olegantonov/skywave-sdr/hardware/d1/plots/filter_response.pdf

### VHF

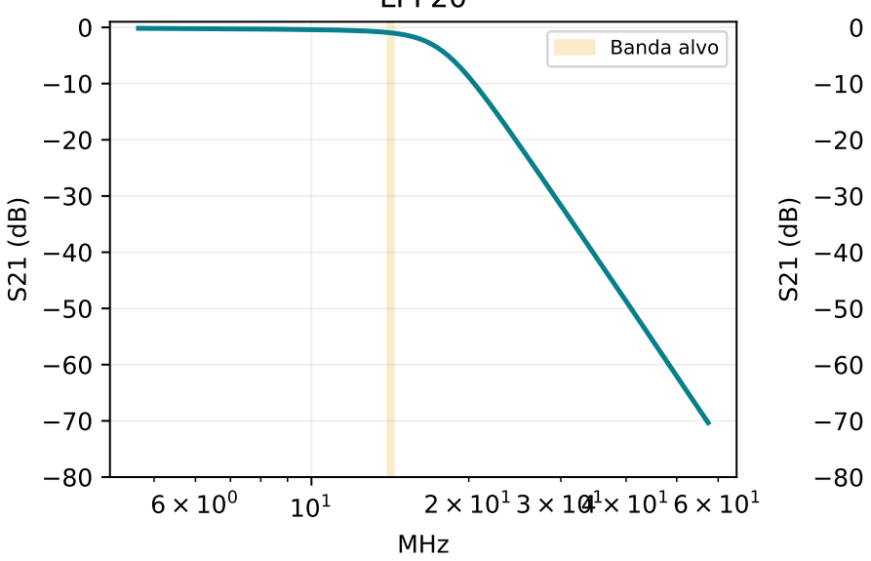
[picture p1: figure]
MHz; Banda alvo
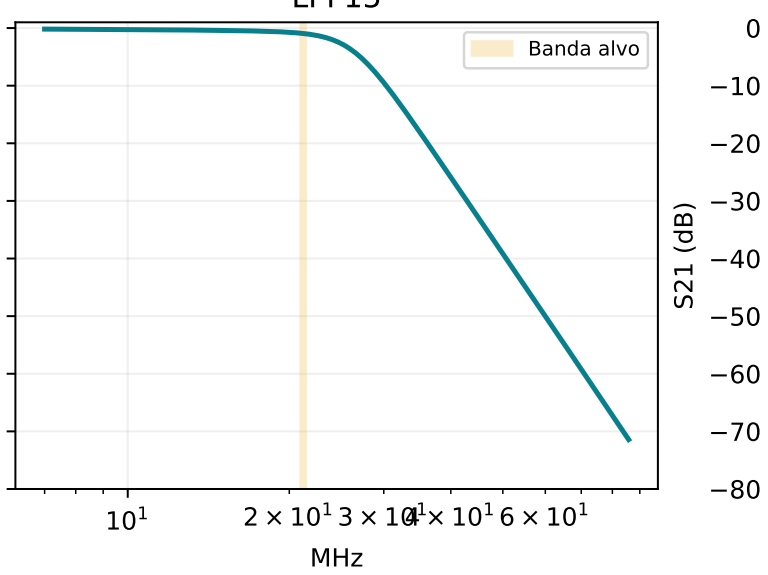
[picture p2: figure]
MHz; Banda alvo

10 2 × 10

2 3 × 104

2× 10

2 6 × 10

2 3
MHz

### UHF

Banda alvo

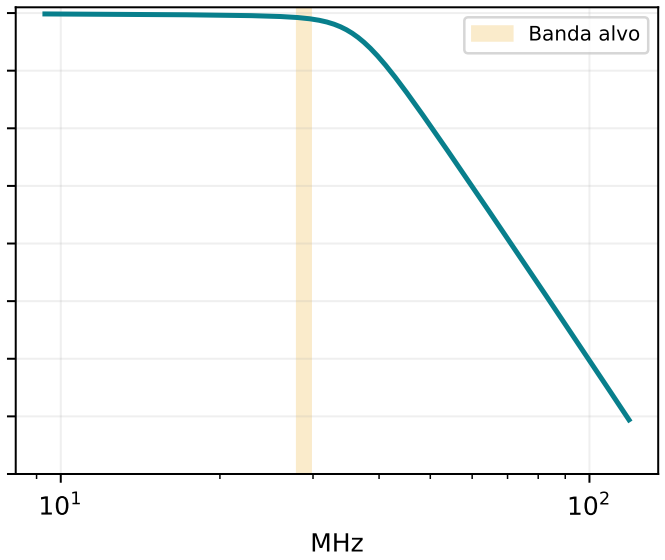
[picture p3: figure]
MHz; Banda alvo

10 3 × 104

0× 10

0 6 × 10

0 | 1 | 2 × 10

1 3 × 10

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
S21 (dB)

### LPF40

Banda alvo

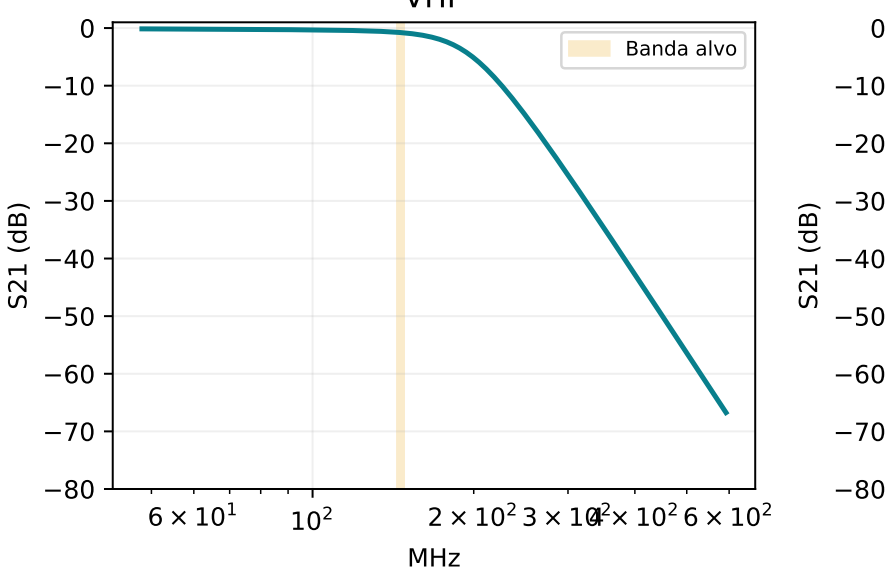
[picture p4: figure]
MHz; Banda alvo

### LPF20

### LPF15

### LPF10

## SkyWave D1 — simulação dos filtros (não é medição)
