olegantonov/skywave-sdr/hardware/d1/plots/filter_response.png

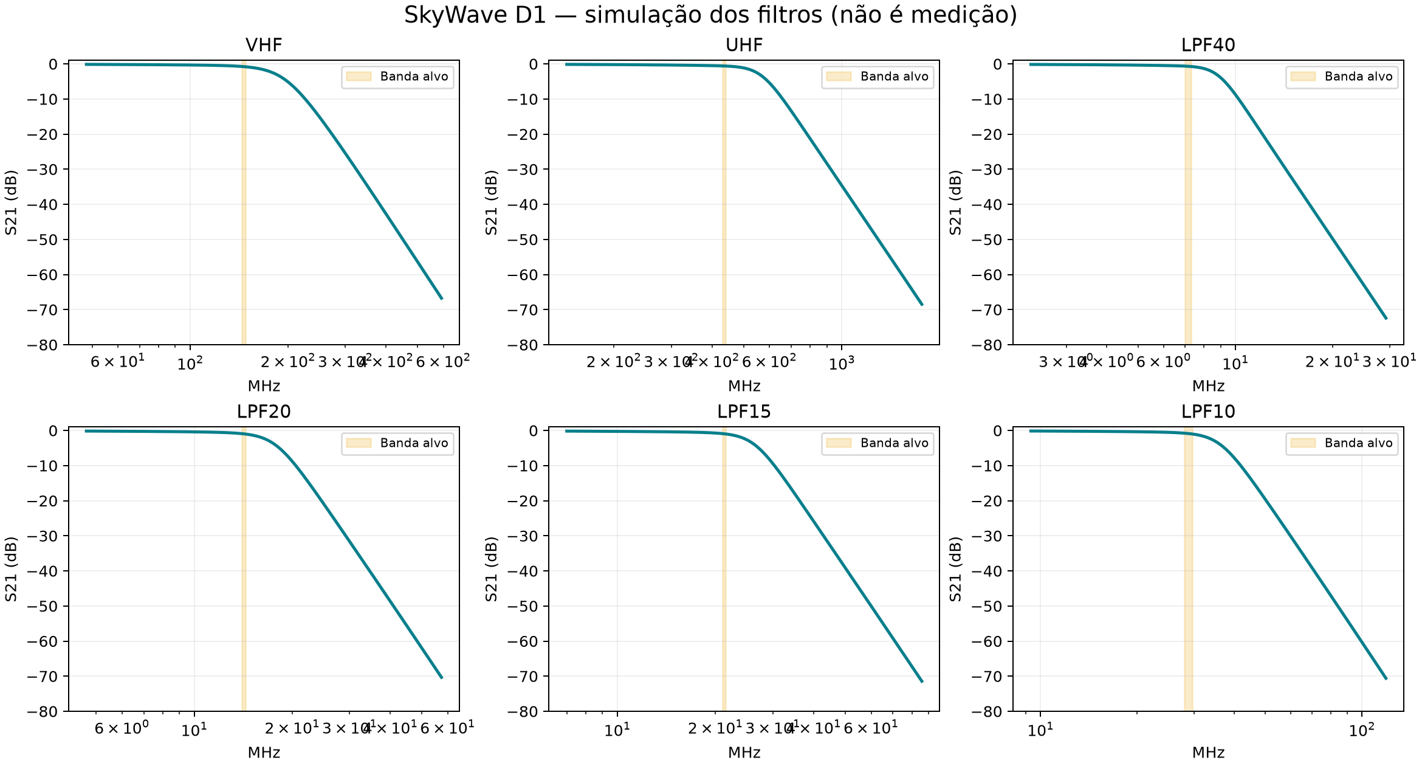
hardware/d1/plots/filter_response.png
