olegantonov/skywave-sdr/hardware/d1/cad/uhf_assembly.step

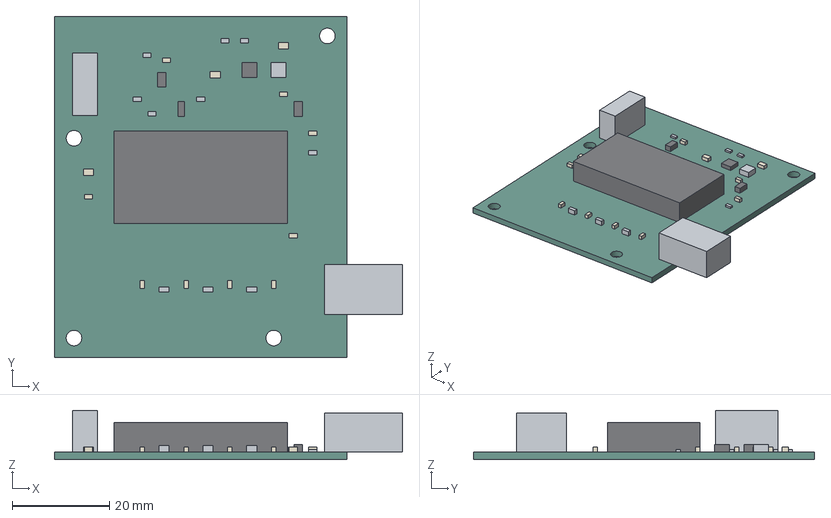
[picture p6: CAD file, 2026-10-12]
hardware/d1/cad/uhf_assembly.step
71.4 x 70.0 x 10.1 mm
laminate
U2
R7
C8
L3
C12
L4
C1
C3
L1
R1
R5
U4
C5
J1
R4
C2
C9
C7
C11
L2
C10
U1
R2
U3
Q1
C6
J2
R6
C4
R3
