olegantonov/skywave-sdr/hardware/d1/cad/lpf10_assembly.step

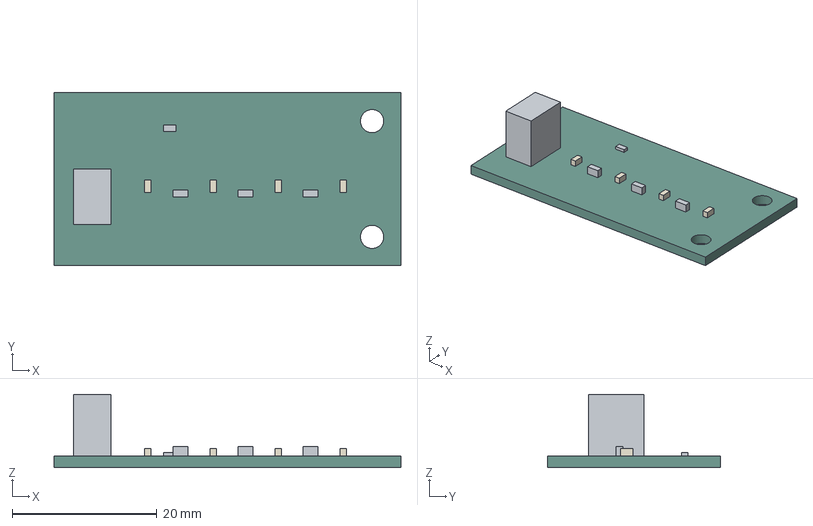
[picture p7: CAD file, 2026-10-12]
hardware/d1/cad/lpf10_assembly.step
48.0 x 24.0 x 10.1 mm
laminate
J1
C1
L1
C2
L2
C3
L3
C4
R1
