olegantonov/skywave-sdr/hardware/d1/cad/control_assembly.step

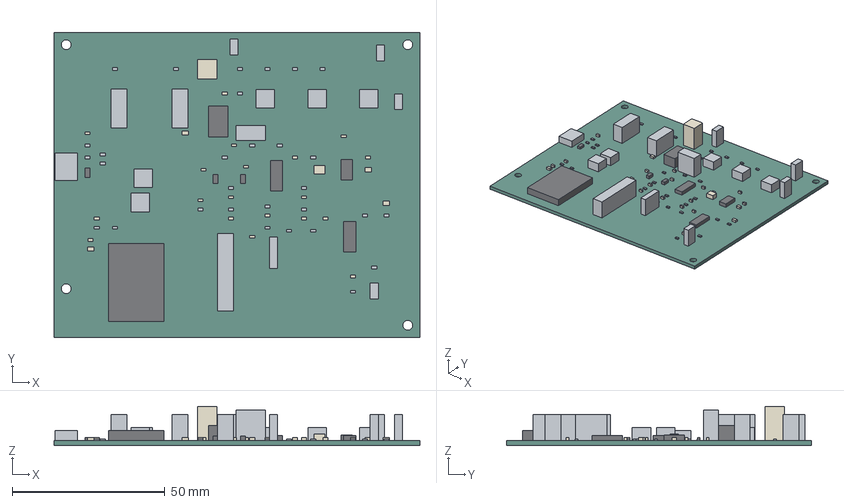
[picture p8: CAD file, 2026-10-12]
hardware/d1/cad/control_assembly.step
120.0 x 100.0 x 12.8 mm
laminate
U1
R1
C1
R2
SW1
SW2
SW3
SW4
SW5
R3
R4
R5
R6
J1
J2
R7
R8
R9
C2
J3
U2
C3
C4
C5
R10
C6
C7
J4
R11
R12
R13
R14
C8
U3
U4
U5
R15
U6
R16
R17
J5
J6
R18
J7
R19
U7
R20
R21
C9
C10
R22
C11
R23
C12
R24
C13
R25
C14
R26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
