olegantonov/skywave-sdr/hardware/d1/cad/control_bare_board.step

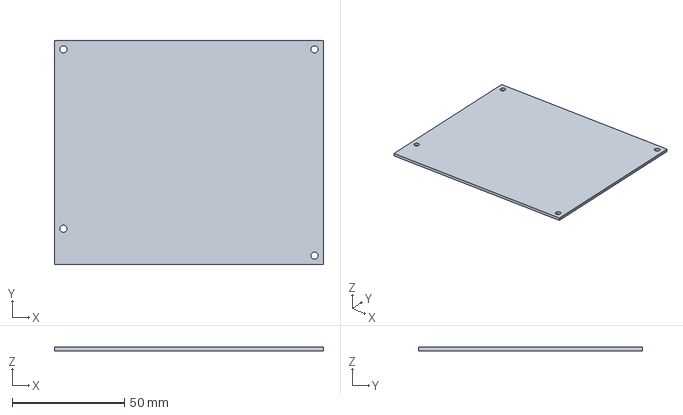
[picture p9: CAD file, 2026-10-12]
hardware/d1/cad/control_bare_board.step
120.0 x 100.0 x 1.60 mm
