olegantonov/skywave-sdr/hardware/d1/cad/button_1.stl

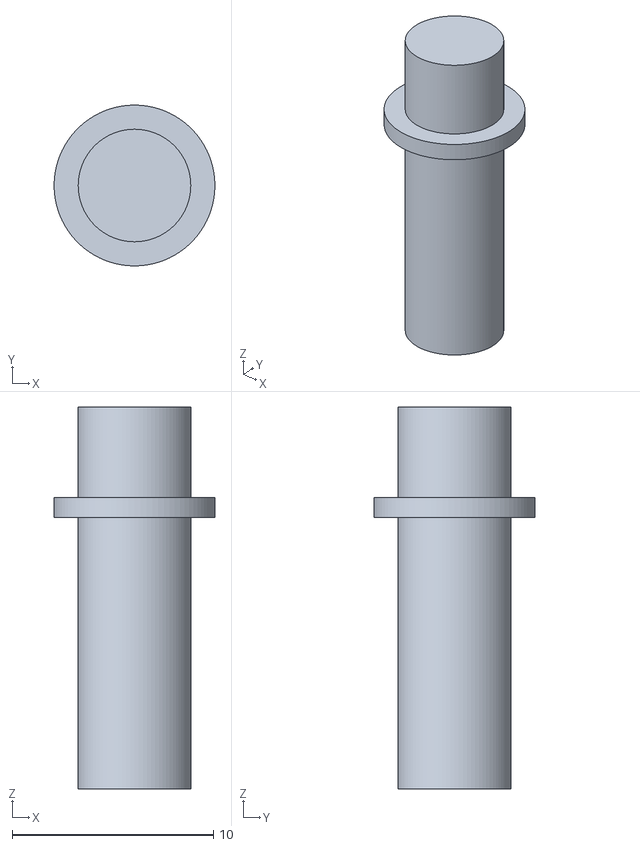
[picture p10: CAD file, 2026-10-12]
hardware/d1/cad/button_1.stl
8.00 x 8.00 x 19.0
