olegantonov/skywave-sdr/hardware/d1/cad/lpf40_bare_board.step

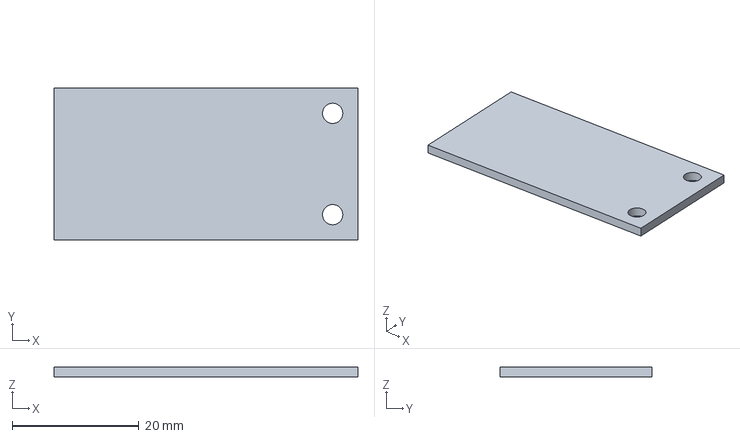
[picture p11: CAD file, 2026-10-12]
hardware/d1/cad/lpf40_bare_board.step
48.0 x 24.0 x 1.60 mm
