olegantonov/skywave-sdr/hardware/d1/cad/enclosure_lid.stl

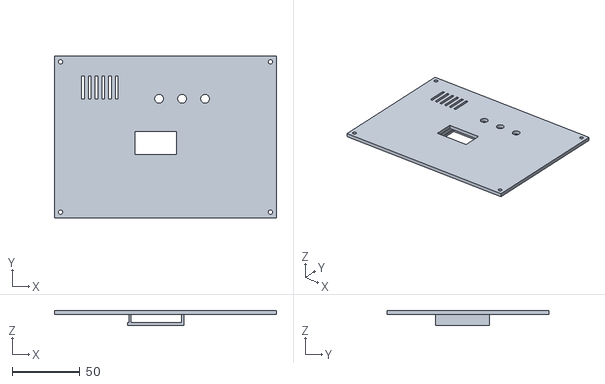
[picture p12: CAD file, 2026-10-12]
hardware/d1/cad/enclosure_lid.stl
164.0 x 120.0 x 11.0
