olegantonov/skywave-sdr/hardware/d1/cad/enclosure_base.step

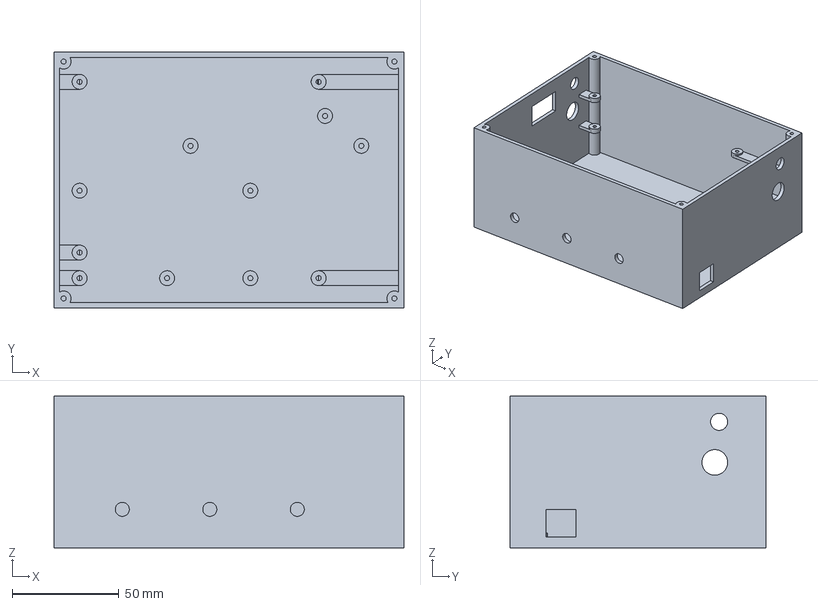
[picture p13: CAD file, 2026-10-12]
hardware/d1/cad/enclosure_base.step
164.0 x 120.0 x 71.0 mm
