olegantonov/skywave-sdr/(list of files, cad)

Other CAD files:
hardware/d1/cad/vhf_assembly.step
hardware/d1/cad/lpf15_assembly.step
hardware/d1/cad/lpf40_assembly.step
hardware/d1/cad/lpf20_assembly.step
hardware/d1/cad/lpf20_bare_board.step
hardware/d1/cad/control_bare_board.stl
hardware/d1/cad/lpf40_bare_board.stl
