olegantonov/skywave-sdr/hardware/d1/plots/control_schematic.pdf

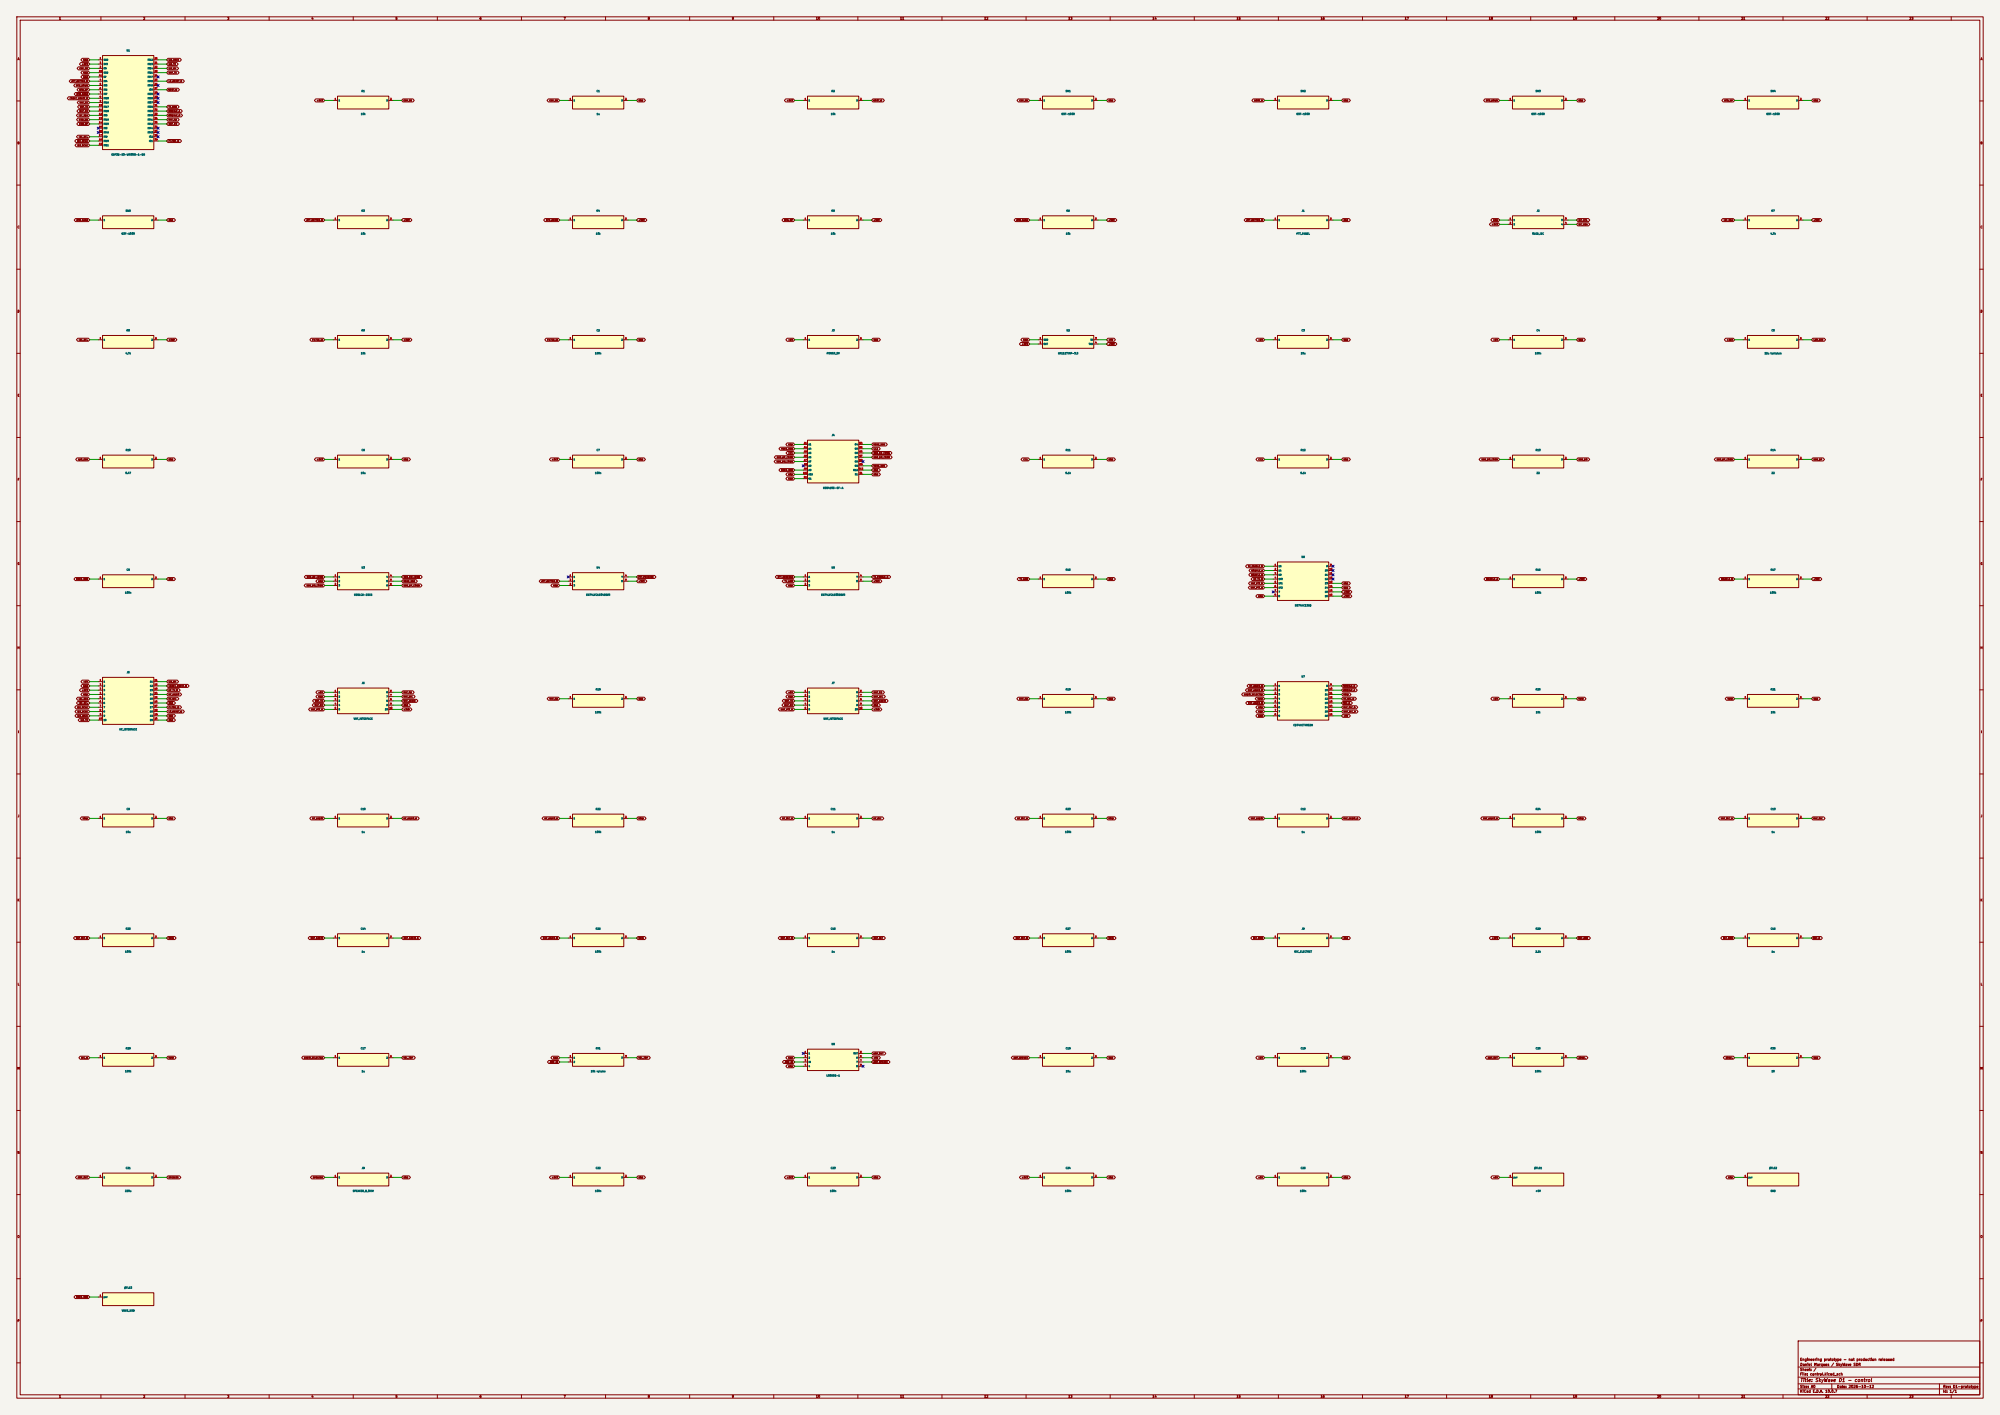
[picture p14: page 1]

Engineering prototype - not production released
Daniel Marques / SkyWave SDR
Sheet: /
File: control.kicad_sch
Title: SkyWave D1 - control

Size: A0 | Rev: D1-prototype
KiCad E.D.A. 10.0.7 | Id: 1/1
