olegantonov/skywave-sdr/hardware/d1/plots/lpf10_schematic.pdf

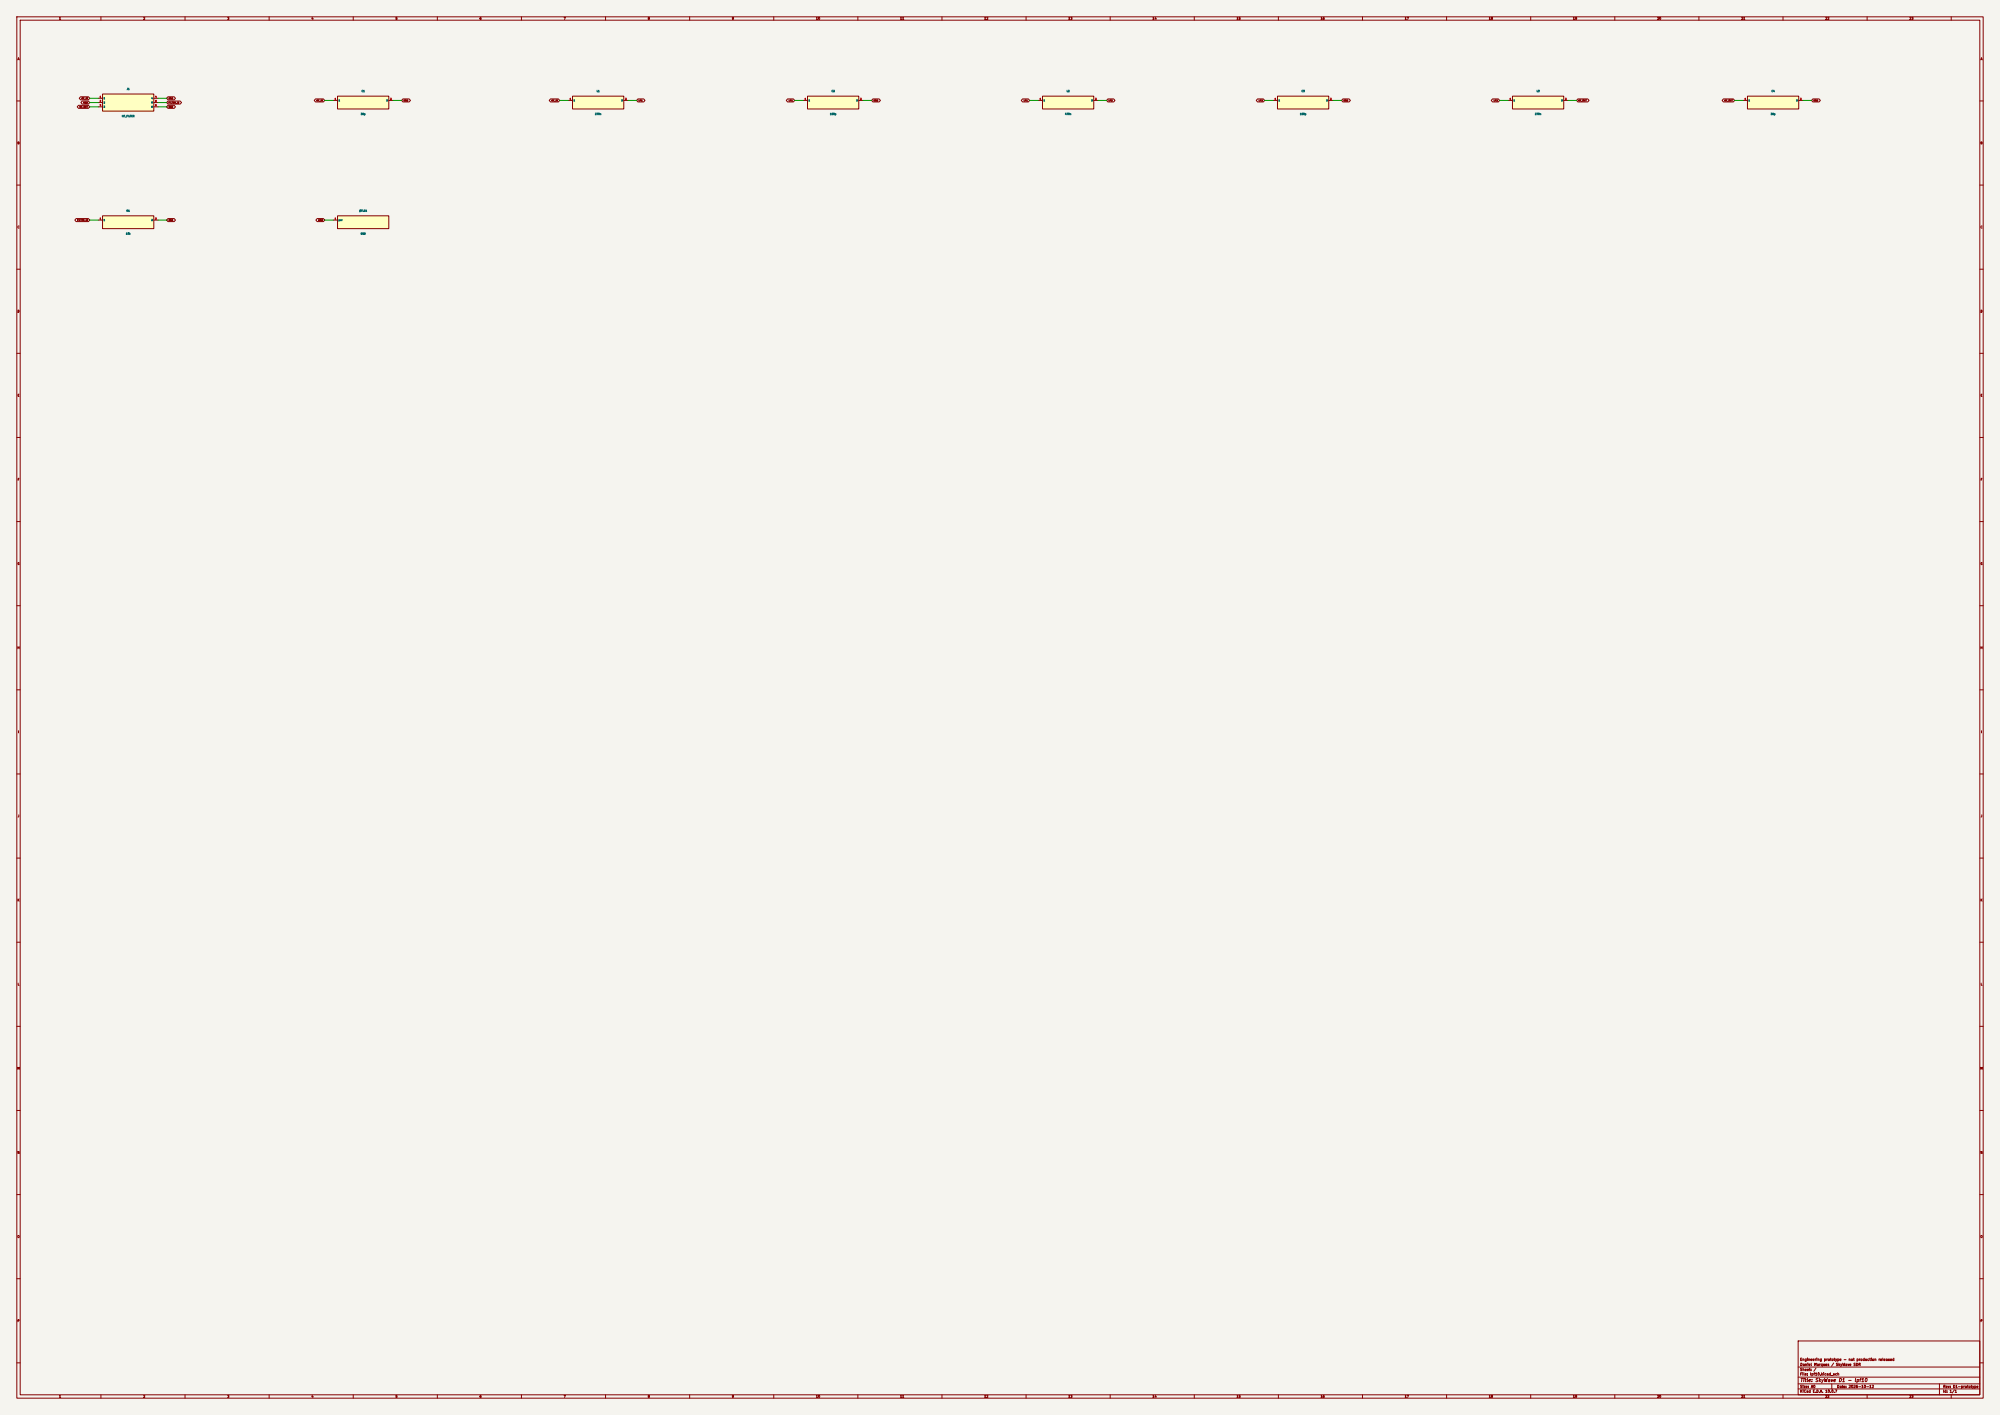
[picture p15: page 1]

Engineering prototype - not production released
Daniel Marques / SkyWave SDR
Sheet: /
File: lpf10.kicad_sch
Title: SkyWave D1 - lpf10

Size: A0 | Rev: D1-prototype
KiCad E.D.A. 10.0.7 | Id: 1/1
