olegantonov/skywave-sdr/hardware/d1/plots/lpf15_schematic.pdf

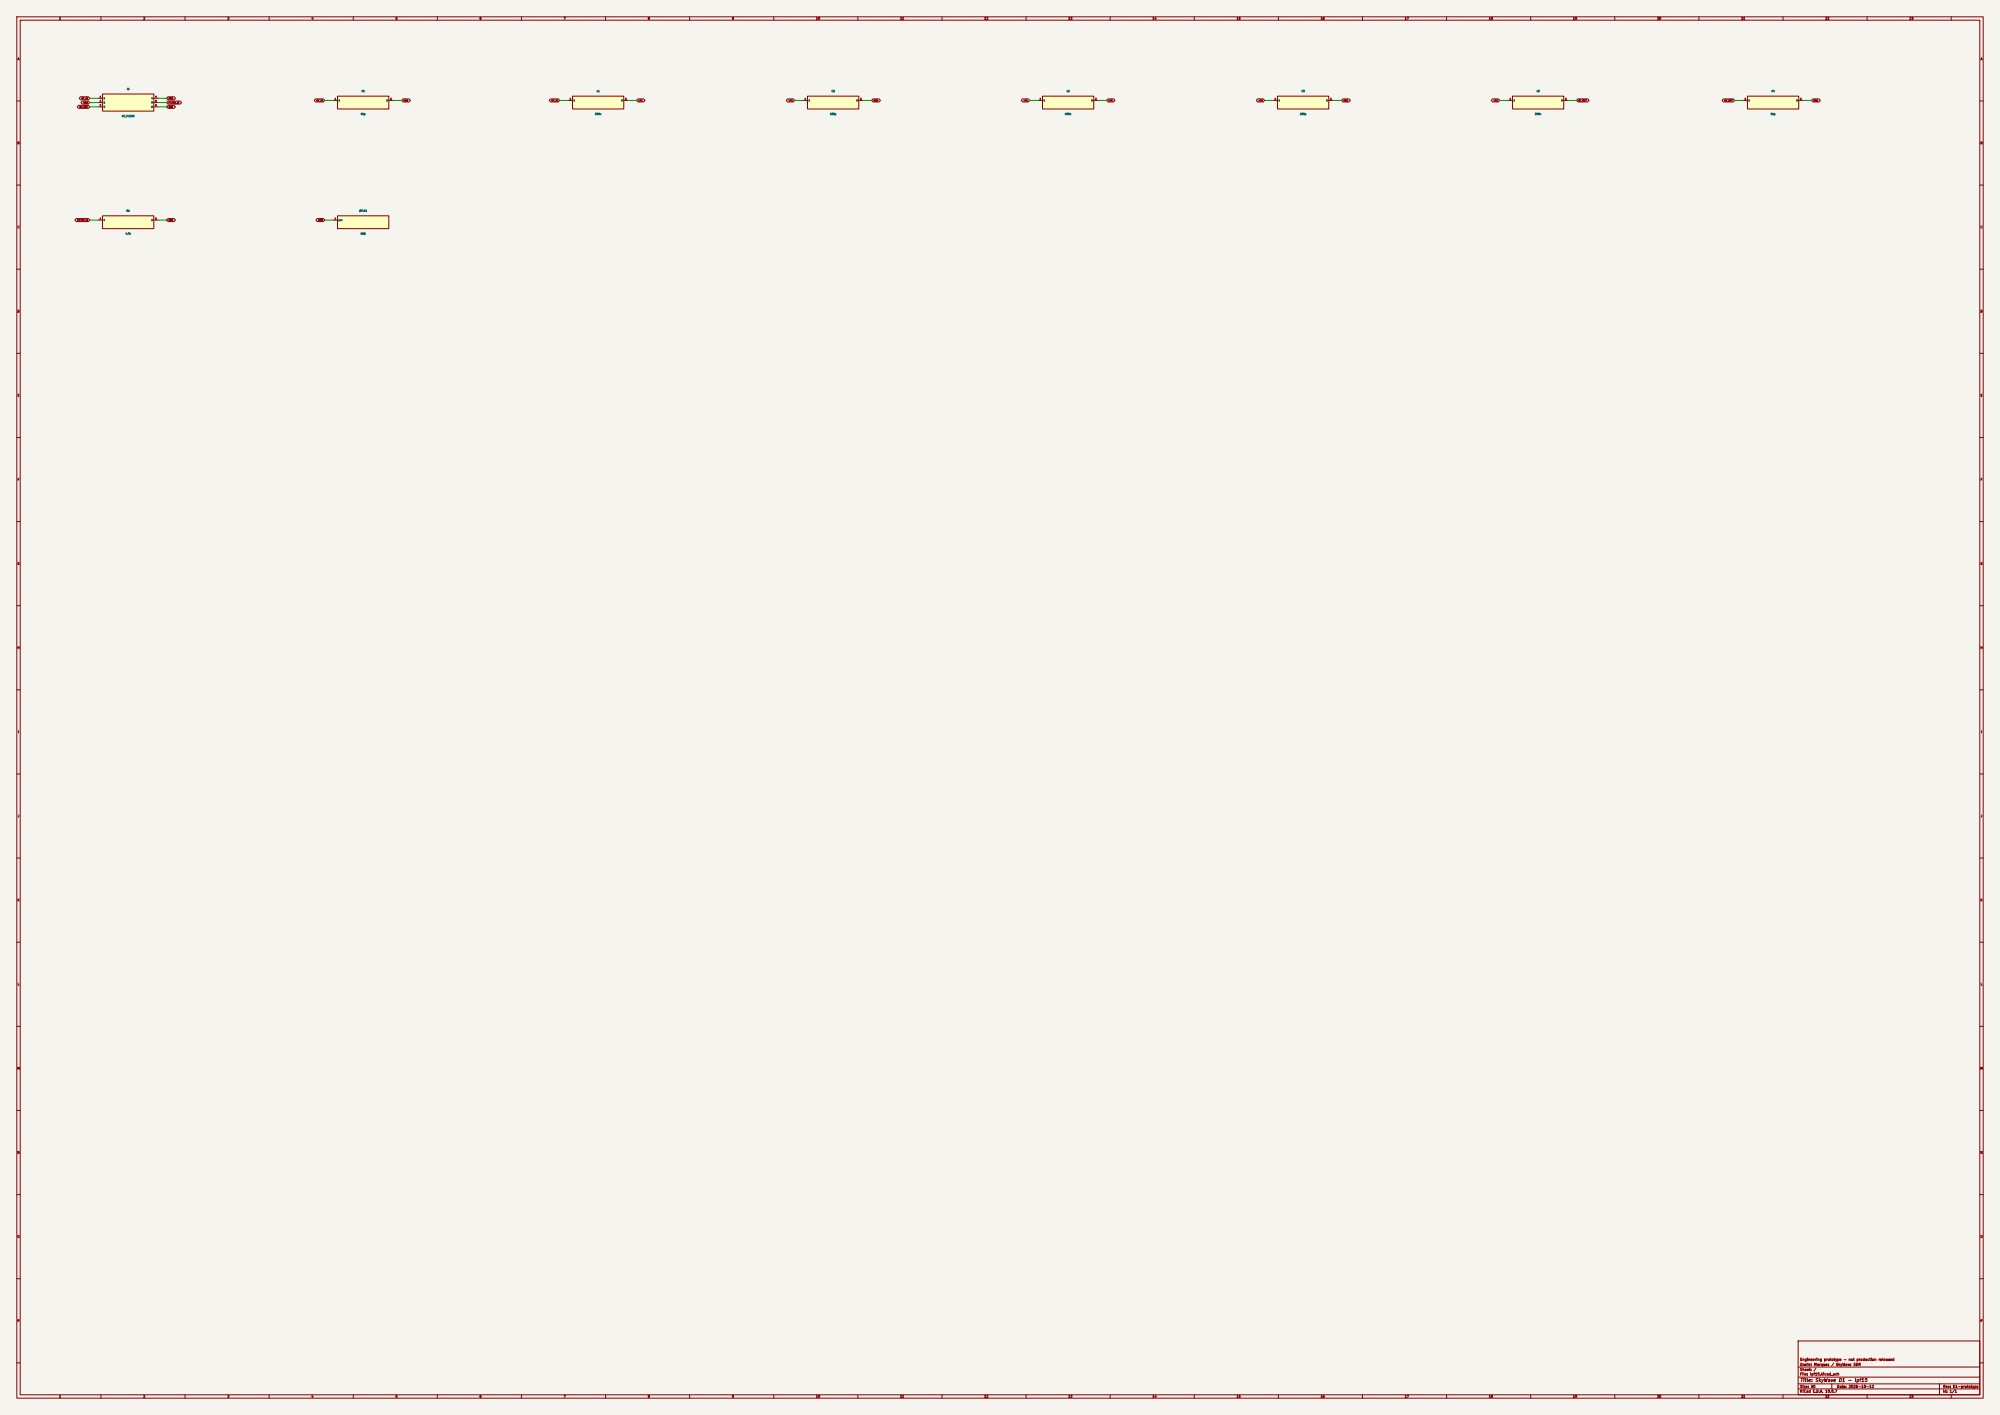
[picture p16: page 1]

Engineering prototype - not production released
Daniel Marques / SkyWave SDR
Sheet: /
File: lpf15.kicad_sch
Title: SkyWave D1 - lpf15

Size: A0 | Rev: D1-prototype
KiCad E.D.A. 10.0.7 | Id: 1/1
