olegantonov/skywave-sdr/hardware/d1/simulation/uhf.cir

SkyWave uhf nominal LPF; ideal LC, 50 ohm terminations
V1 source 0 AC 1
RS source n0 50
RL n3 0 50
C1 n0 0 2.4p
L1 n0 n1 18n
C2 n1 0 10p
L2 n1 n2 27n
C3 n2 0 10p
L3 n2 n3 18n
C4 n3 0 2.4p
.control
set wr_singlescale
set wr_vecnames
ac dec 150 143333333.33333334 1760000000.0
let s21_db = db(v(n3)*2)
wrdata uhf.dat s21_db
quit
.endc
.end
