olegantonov/skywave-sdr/(list of files, drawings)

Other design files:
hardware/d1/ecad/lpf15.dsn
hardware/d1/ecad/lpf40.dsn
hardware/d1/ecad/uhf.dsn
