olegantonov/skywave-sdr/hardware/d1/ecad/hf.kicad_pcb

## KiCad design hardware/d1/ecad/hf.kicad_pcb (2026-10-12)

Schematic: hf.kicad_sch, SkyWave D1 - hf

Parts:
C1, C2, C8, C9, C16, C20, C22, C25: 1u; Capacitor_SMD_C_0603_1608Metric; MPN KEMET 0603 X7R 25V; 1u; 5% RF/10% decou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
C3, C4, C5, C6, C10, C11, C21, C28, C29, C30, C35, C36: 100n; Capacitor_SMD_C_0603_1608Metric; MPN KEMET 0603 X7R 25V; 100n; 5% RF/10% dec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
C7, C12, C37, C38: 10u; Capacitor_SMD_C_0805_2012Metric; MPN KEMET 0805 X7R 25V; 10u; 5% RF/10% deco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
C13, C14, C17, C18: 100p; Capacitor_SMD_C_0603_1608Metric; MPN KEMET 0603 C0G 25V; 100p; 5% RF/10% dec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
C15, C19, C23, C24, C26, C27, C31, C32, C33, C34: 10n; Capacitor_SMD_C_0603_1608Metric; MPN KEMET 0603 C0G 25V; 10n; 5% RF/10% deco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
D1: 1N4148W; Diode_SMD_D_SOD-123; MPN 1N4148W
J1: CONTROL_INTERFACE; Connector_PinHeader_2.54mm_PinHeader_2x10_P2.54mm_Vertical; MPN Samtec TSW-010-07-D-S
J2: FILTER_CARTRIDGE; Connector_PinHeader_2.54mm_PinHeader_2x03_P2.54mm_Vertical; MPN Samtec TSW-003-07-D-S
J3: SMA 132289; Connector_Coaxial_SMA_Amphenol_132289_EdgeMount; MPN Amphenol 132289
K1: G6K-2F-Y-DC5; Relay_SMD_Relay_DPDT_Omron_G6K-2F-Y; MPN G6K-2F-Y-DC5
Q1: 2N7002; Package_TO_SOT_SMD_SOT-23; MPN 2N7002
R1, R3, R4, R5, R6, R7, R9, R12, R14, R18, R19, R23, R24: 10k; Resistor_SMD_R_0603_1608Metric; MPN CRCW0603 series; value=10k; 1%
R2: 33; Resistor_SMD_R_0603_1608Metric; MPN CRCW0603 series; value=33; 1%
R8, R10, R13, R15, R17, R22, R29: 100k; Resistor_SMD_R_0603_1608Metric; MPN CRCW0603 series; value=100k; 1%
R11, R16: 1k; Resistor_SMD_R_0603_1608Metric; MPN CRCW0603 series; value=1k; 1%
R20, R21, R25, R26: 100; Resistor_SMD_R_0603_1608Metric; MPN CRCW0603 series; value=100; 1%
R27, R28: 49.9; Resistor_SMD_R_0603_1608Metric; MPN CRCW0603 series; value=49.9; 1%
U1: TLV75518PDBVR; Package_TO_SOT_SMD_SOT-23-5; MPN TLV75518PDBVR
U2: TLV320AIC3204IRHBR; Package_DFN_QFN_Texas_RHB0032E_VQFN-32-1EP_5x5mm_P0.5mm_EP3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; MPN TLV320AIC3204IRHBR
U3: SI5351A-B-GT; Package_SO_MSOP-10_3x3mm_P0.5mm; MPN SI5351A-B-GT
U4: 74LVC74APW; Package_SO_TSSOP-14_4.4x5mm_P0.65mm; MPN 74LVC74APW
U5: SN74LVC1G04DBVR; Package_TO_SOT_SMD_SOT-23-5; MPN SN74LVC1G04DBVR
U6, U7: TLV9064IDR; Package_SO_SOIC-14_3.9x8.7mm_P1.27mm; MPN TLV9064IDR
U8, U9: SN74CBT3253DR; Package_SO_SOIC-16_3.9x9.9mm_P1.27mm; MPN SN74CBT3253DR
Y1: 25MHz 10pF; Crystal_Crystal_SMD_3225-4Pin_3.2x2.5mm; MPN Abracon ABM8-25.000MHZ-10-1-U-T

Connections:
+1V8: C2.1, C4.1, C5.1, U1.5 (OUT), U2.24 (AVDD), U2.29 (DVDD)
+3V3: C1.1, C3.1, C6.1, C10.1, C11.1, C38.1, J1.3, R4.2, U1.1, U1.3, U2.6 (IOVDD), U2.26 (LDOIN), U3.1, U3.7, U4.4, U4.10, U4.14, U5.5
+5V: C21.1, C28.1, C29.1, C30.1, C37.1, D1.1, J1.1, K1.1, R5.1, U6.4, U7.4, U8.16, U9.16
ADC_I: C16.2, U2.13 (IN1L)
ADC_Q: C20.2, U2.14 (IN1R)
ANT_HF: J2.3, J3.1
AUDIO_RAW: C8.1, U2.25 (HPL)
CODEC_REF: C7.1, U2.18 (REF)
CODEC_RESET_N: J1.12, R1.1, U2.31 (RESET)
COIL_LOW: D1.2, K1.8, Q1.3
DAC_I: C22.1, U2.22 (LOL)
DAC_Q: C25.1, U2.23 (LOR)
DET_IN: C34.1, R9.1, U8.3, U8.13
DET_IP: C31.1, R7.1, U8.6, U8.10
DET_QN: C33.1, R14.1, U8.4, U8.12
DET_QP: C32.1, R12.1, U8.5, U8.11
FILTER_ID: J1.17, J2.5
GND: C1.2, C2.2, C3.2, C4.2, C5.2, C6.2, C7.2, C10.2, C11.2, C12.2, C15.2, C19.2, C21.2, C28.2, C29.2, C30.2, C37.2, C38.2, J1.2, J1.4, J1.16, J1.19, J1.20, J2.2, J2.4, J2.6, J3.2, Q1.2, R1.2, R3.2, R6.2, R29.2, U1.2, U2.7 (IOVSS), U2.8 (MFP3), U2.12 (SPI_SEL), U2.17 (AVSS), U2.28 (DVSS), U2.30 (LDO_SEL), U2.33 (EP), U3.8, U4.7, U5.3, U6.11, U7.11, U8.8, U9.8, Y1.2, Y1.4
HF_AUDIO: C8.2, J1.14
HF_MIC: C9.1, J1.15
HF_TX: Q1.1, R29.1, U5.4 (Y), U8.1, U8.15
HF_TX_N: J1.13, R4.1, U5.2, U9.1, U9.15
I2C_SCL: J1.6, U2.9 (SCL), U3.4 (SCL)
I2C_SDA: J1.5, U2.10 (SDA), U3.5 (SDA)
I2S_BCLK: J1.8, U2.2 (BCLK)
I2S_LRCK: J1.9, U2.3 (WCLK)
I2S_MCLK: J1.7, U2.1 (MCLK)
I2S_RX: J1.11, U2.5 (DOUT)
I2S_TX: J1.10, U2.4 (DIN)
LO4: R2.2, U4.3, U4.11
LO4_RAW: R2.1, U3.10 (CLK0)
LO_I: U4.5 (1Q), U4.12, U8.14, U9.14
LO_Q: U4.9 (2Q), U8.2, U9.2
LO_Q_N: U4.2, U4.8 (2Q_N)
LO_RESET_N: J1.18, R3.1, U4.1, U4.13
LP_I: C15.1, C16.1, R11.2
LP_Q: C19.1, C20.1, R16.2
MIC_IN: C9.2, U2.15 (IN2L)
MIX_RX: C35.2, R27.1, U8.7, U8.9
MIX_TX: C36.1, U9.7, U9.9
RF_COMMON: J2.1, K1.3
RF_RX: C35.1, K1.2
RF_TX: K1.4, R28.2
RX_I: C14.2, R10.2, R11.1, U6.1 (OUT1)
RX_I_NEG: C14.1, R9.2, R10.1, U6.2
RX_I_POS: C13.1, R7.2, R8.1, U6.3
RX_Q: C18.2, R15.2, R16.1, U6.7 (OUT2)
RX_Q_NEG: C18.1, R14.2, R15.1, U6.6
RX_Q_POS: C17.1, R12.2, R13.1, U6.5
SPARE_OUT: U6.13, U6.14 (OUT4)
TX_AC: C36.2, R28.1
TX_IN: R19.2, R21.1, U7.7 (OUT2)
TX_IN_F: C24.1, R21.2, U9.3, U9.13
TX_IP: R18.1, R20.1, U7.1 (OUT1), U7.2
TX_IP_F: C23.1, R20.2, U9.6, U9.10
TX_I_BIAS: C22.2, R17.1, U7.3
TX_I_INV: R18.2, R19.1, U7.6
TX_QN: R24.2, R26.1, U7.14 (OUT4)
TX_QN_F: C27.1, R26.2, U9.4, U9.12
TX_QP: R23.1, R25.1, U7.8 (OUT3), U7.9
TX_QP_F: C26.1, R25.2, U9.5, U9.11
TX_Q_BIAS: C25.2, R22.1, U7.10
TX_Q_INV: R23.2, R24.1, U7.13
VMID: C13.2, C17.2, C23.2, C24.2, C26.2, C27.2, C31.2, C32.2, C33.2, C34.2, R8.2, R13.2, R17.2, R22.2, R27.2, U6.8 (OUT3), U6.9, U6.12, U7.5, U7.12
VMID_RAW: C12.1, R5.2, R6.1, U6.10
XTAL_A: U3.2, Y1.1
XTAL_B: U3.3, Y1.3

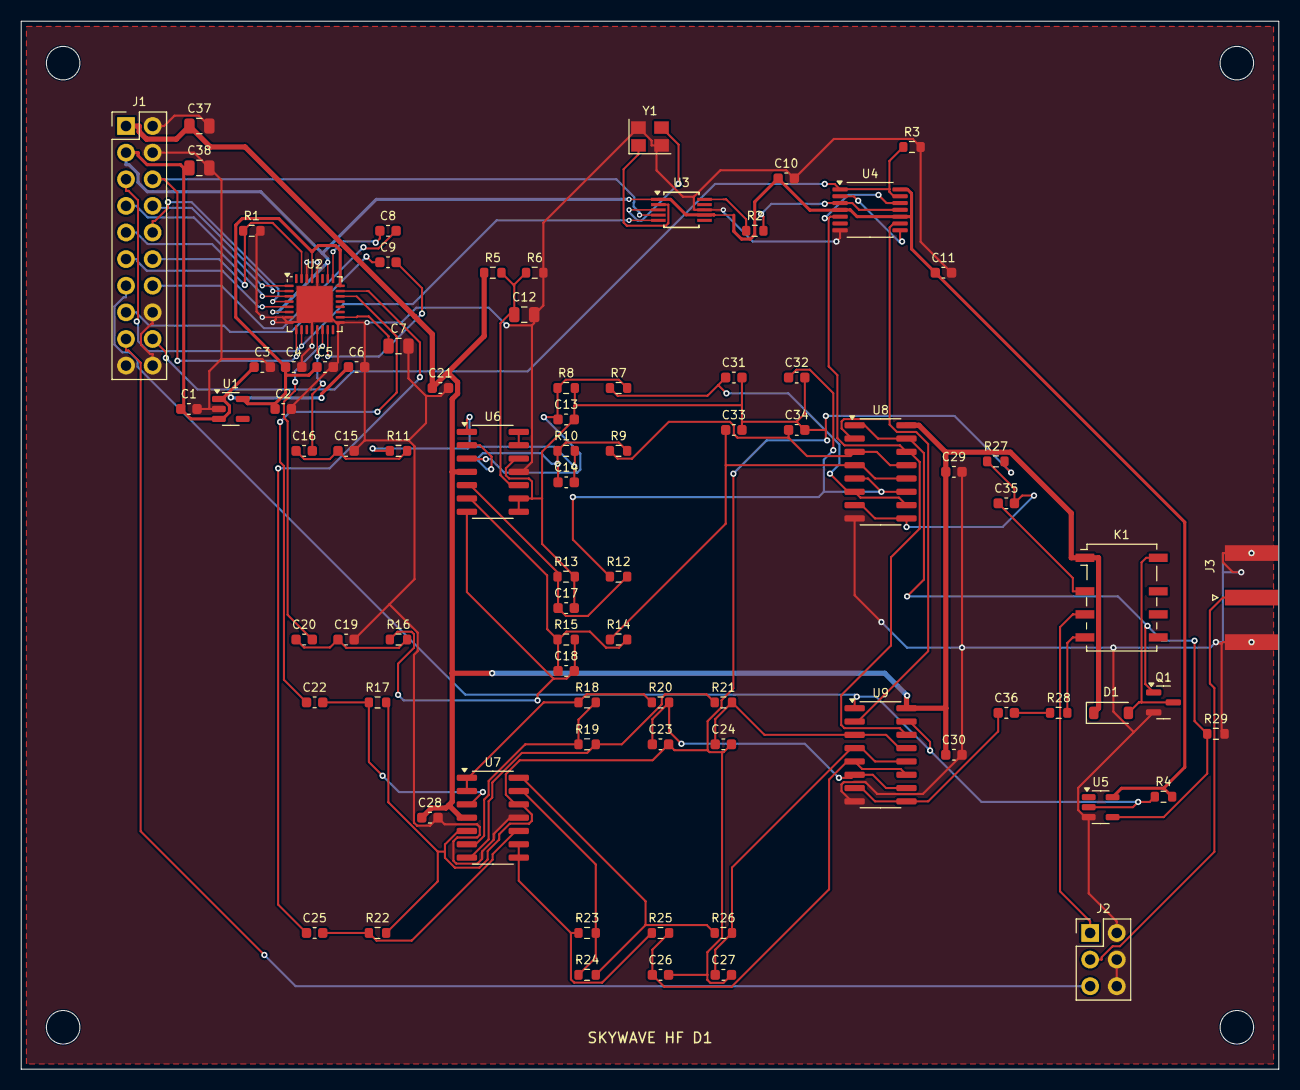
[picture p17: board hf.kicad_pcb from above]

Board: 4 copper layers, 120.0 x 100.0 mm, 87 parts (0 on the bottom side), 67 nets.

Other parts of the board:
H1, H2, H3, H4: MountingHole_3.2mm_M3
