olegantonov/skywave-sdr/hardware/d1/ecad/lpf20.kicad_pcb

## KiCad design hardware/d1/ecad/lpf20.kicad_pcb (2026-10-12)

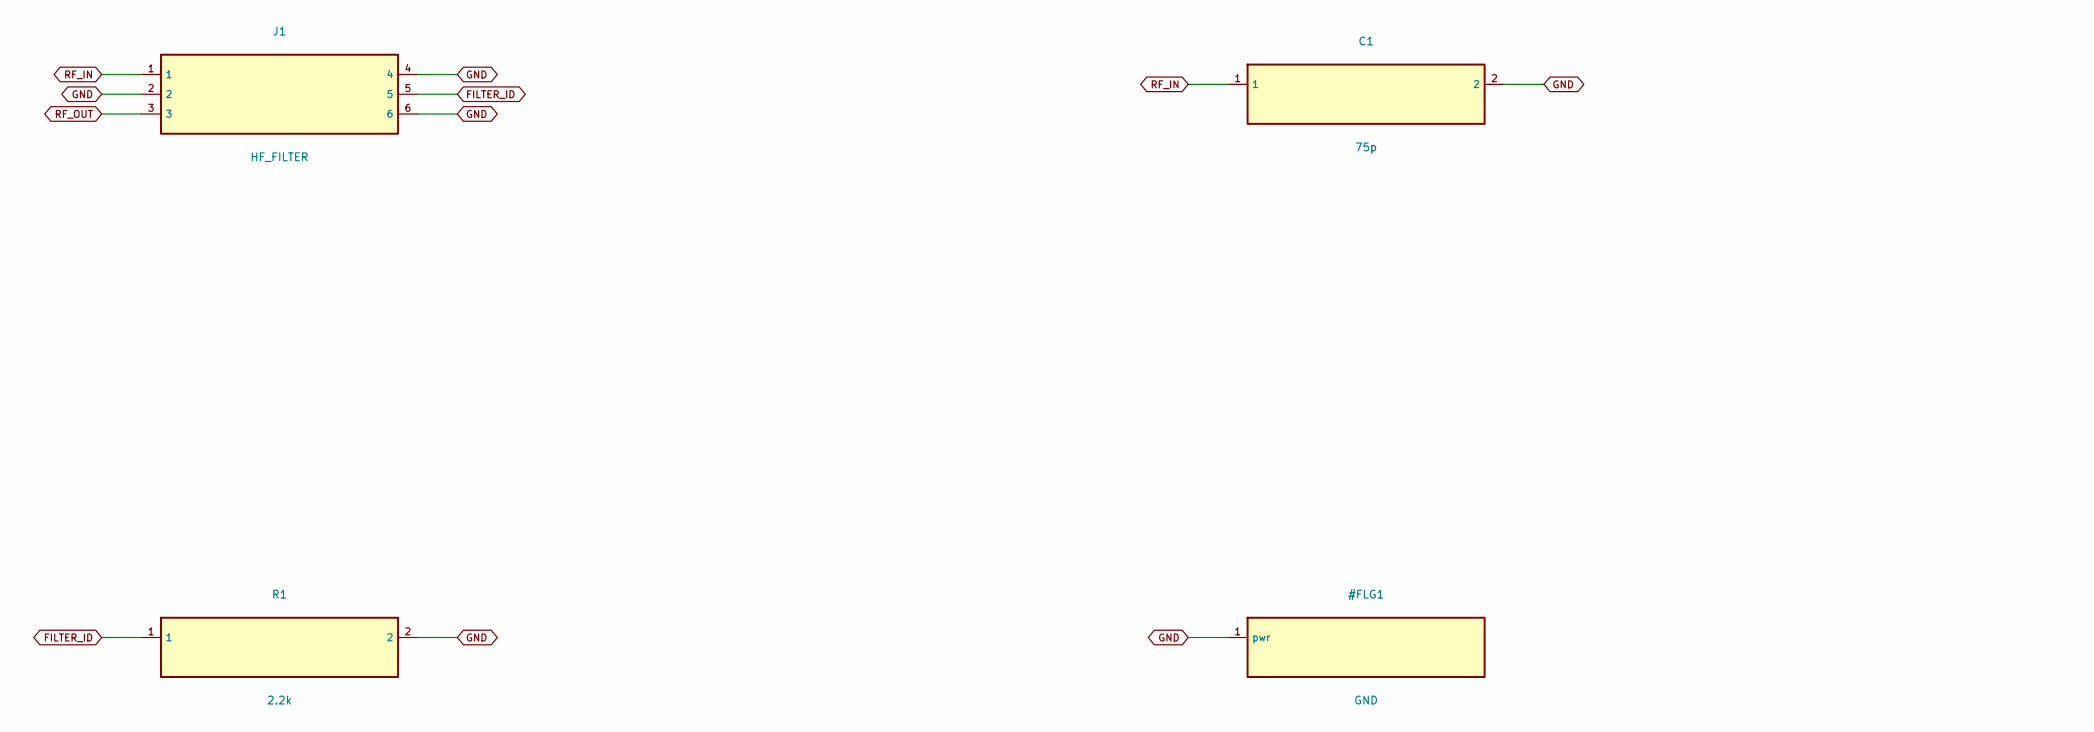
[picture p18: schematic lpf20.kicad_sch, SkyWave D1 - lpf20, part in row 1, column 1]

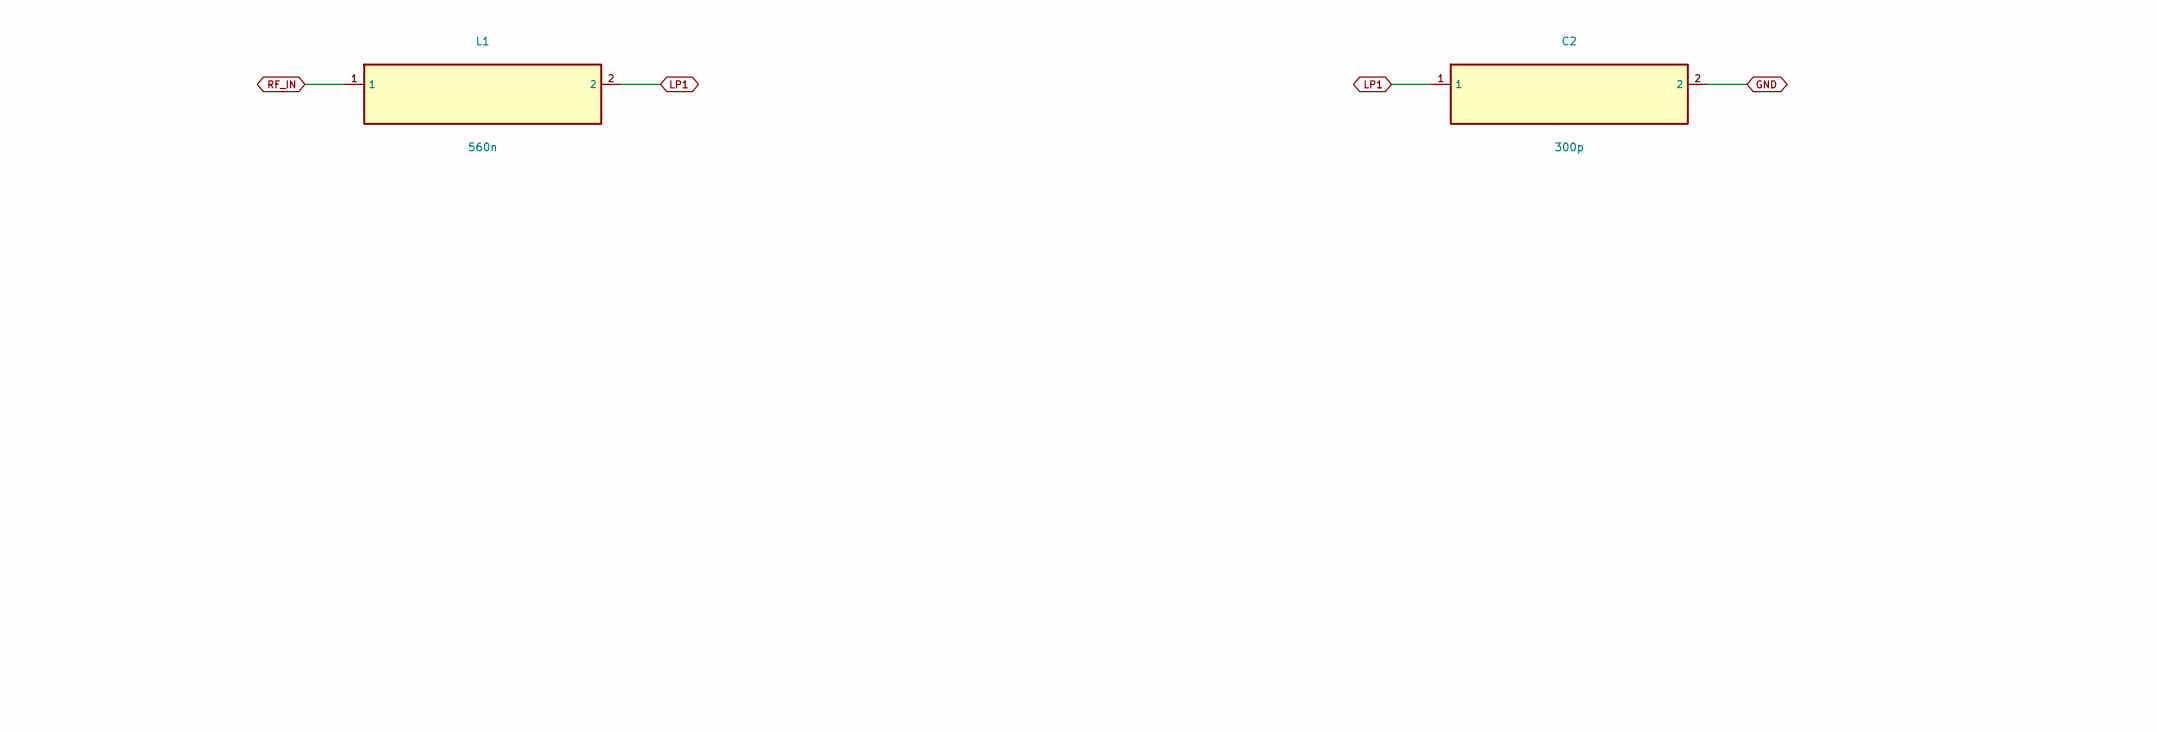
[picture p19: schematic lpf20.kicad_sch, SkyWave D1 - lpf20, part in row 1, column 2]

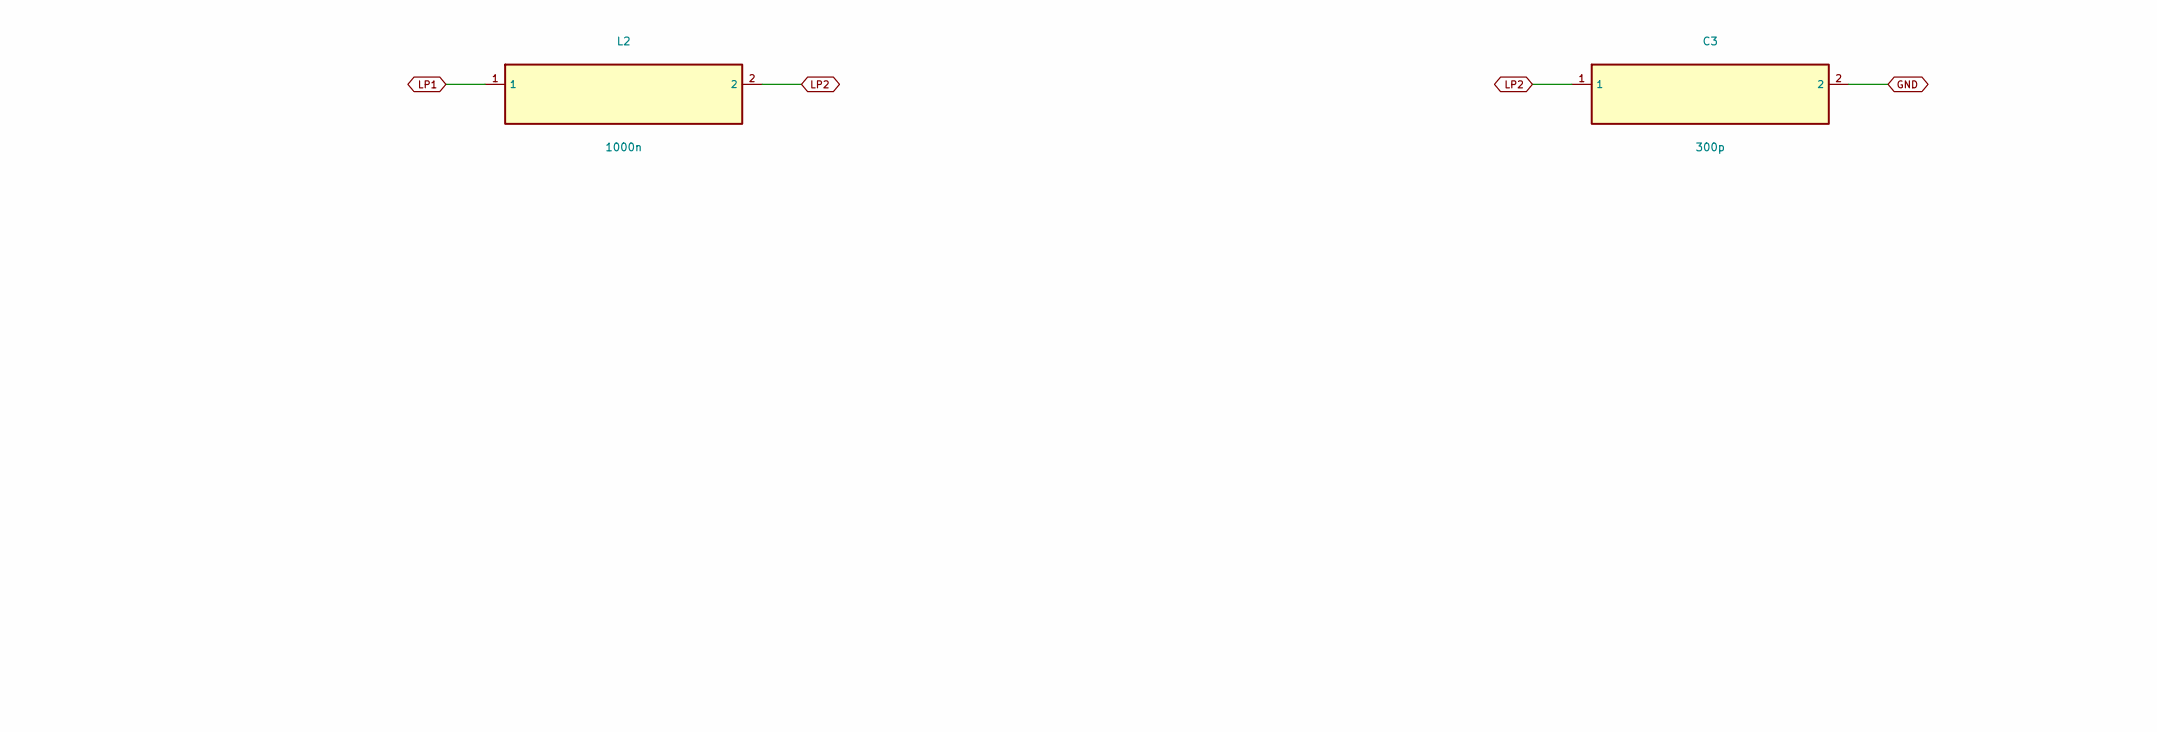
[picture p20: schematic lpf20.kicad_sch, SkyWave D1 - lpf20, part in row 1, column 3]

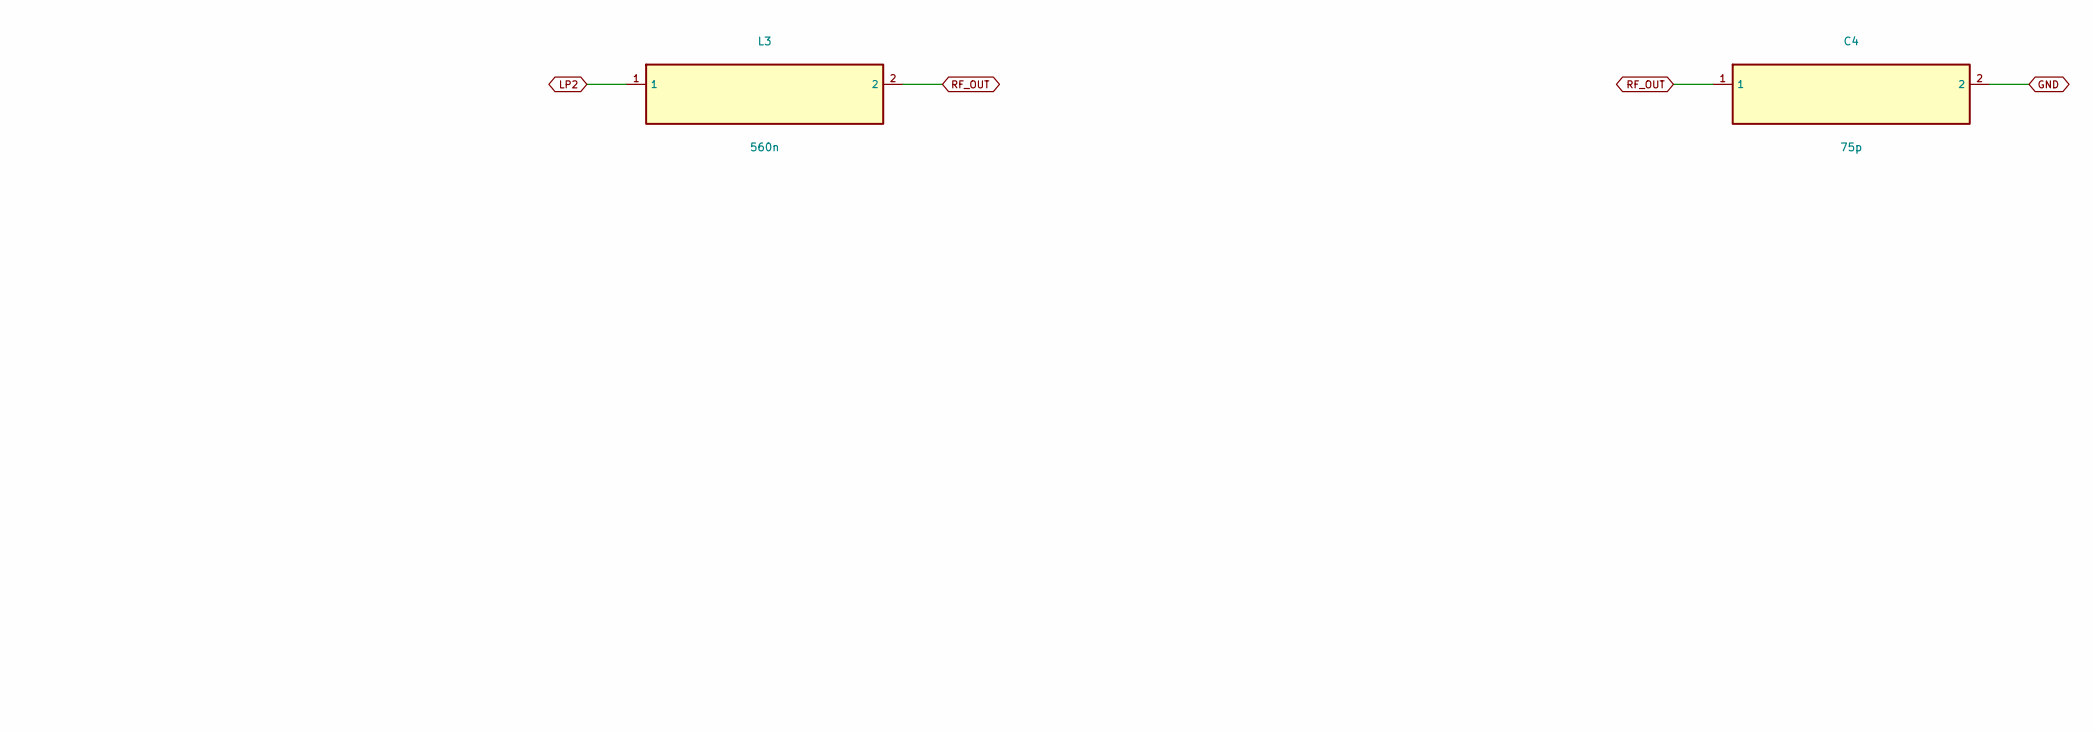
[picture p21: schematic lpf20.kicad_sch, SkyWave D1 - lpf20, part in row 1, column 4]

Parts:
C1, C4: 75p; Capacitor_SMD_C_0603_1608Metric; MPN KEMET 0603 C0G 25V; 75p; 5% RF/10% deco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
C2, C3: 300p; Capacitor_SMD_C_0603_1608Metric; MPN KEMET 0603 C0G 25V; 300p; 5% RF/10% dec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
J1: HF_FILTER; Connector_PinHeader_2.54mm_PinHeader_2x03_P2.54mm_Vertical; MPN Samtec TSW-003-07-D-S
L1, L3: 560n; Inductor_SMD_L_0805_2012Metric; MPN 0805CS-561XJRC
L2: 1000n; Inductor_SMD_L_0805_2012Metric; MPN 0805CS-102XJRC
R1: 2.2k; Resistor_SMD_R_0603_1608Metric; MPN CRCW0603 series; value=2.2k; 1%

Connections:
FILTER_ID: J1.5, R1.1
GND: C1.2, C2.2, C3.2, C4.2, J1.2, J1.4, J1.6, R1.2
LP1: C2.1, L1.2, L2.1
LP2: C3.1, L2.2, L3.1
RF_IN: C1.1, J1.1, L1.1
RF_OUT: C4.1, J1.3, L3.2

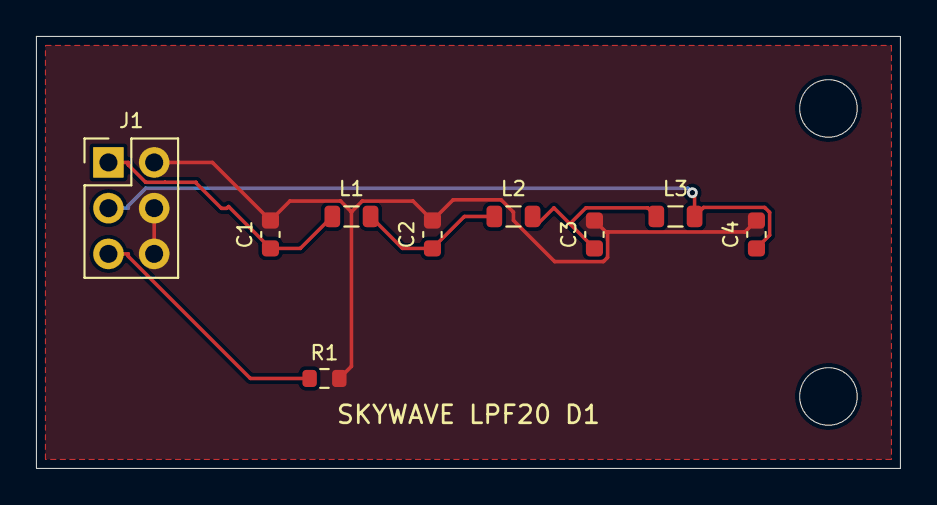
[picture p22: board lpf20.kicad_pcb from above]

Board: 4 copper layers, 48.0 x 24.0 mm, 11 parts (0 on the bottom side), 6 nets.

Other parts of the board:
H1, H2: MountingHole_3.2mm_M3
