olegantonov/skywave-sdr/hardware/d1/ecad/uhf.kicad_pcb

## KiCad design hardware/d1/ecad/uhf.kicad_pcb (2026-10-12)

Schematic: uhf.kicad_sch, SkyWave D1 - uhf

Parts:
C1: 10u; Capacitor_SMD_C_0805_2012Metric; MPN KEMET 0805 X7R 25V; 10u; 5% RF/10% deco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
C2, C4: 22u; Capacitor_SMD_C_0805_2012Metric; MPN KEMET 0805 X7R 25V; 22u; 5% RF/10% deco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
C3, C5, C6: 100n; Capacitor_SMD_C_0603_1608Metric; MPN KEMET 0603 X7R 25V; 100n; 5% RF/10% dec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
C7, C8: 1u; Capacitor_SMD_C_0603_1608Metric; MPN KEMET 0603 X7R 25V; 1u; 5% RF/10% decou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
C9, C12: 2.4p; Capacitor_SMD_C_0603_1608Metric; MPN KEMET 0603 C0G 25V; 2.4p; 5% RF/10% dec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
C10, C11: 10p; Capacitor_SMD_C_0603_1608Metric; MPN KEMET 0603 C0G 25V; 10p; 5% RF/10% deco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
J1: CONTROL_INTERFACE; Connector_PinHeader_2.54mm_PinHeader_2x05_P2.54mm_Vertical; MPN Samtec TSW-005-07-D-S
J2: SMA 132289; Connector_Coaxial_SMA_Amphenol_132289_EdgeMount; MPN Amphenol 132289
L1: 2.2u; VLS3015ET; MPN VLS3015ET-2R2M
L2, L4: 18n; Inductor_SMD_L_0805_2012Metric; MPN 0805CS-180XJRC
L3: 27n; Inductor_SMD_L_0805_2012Metric; MPN 0805CS-270XJRC
Q1: 2N7002; Package_TO_SOT_SMD_SOT-23; MPN 2N7002
R1: 402k; Resistor_SMD_R_0603_1608Metric; MPN CRCW0603 series; value=402k; 1%
R2, R5, R6: 100k; Resistor_SMD_R_0603_1608Metric; MPN CRCW0603 series; value=100k; 1%
R3: 1k; Resistor_SMD_R_0603_1608Metric; MPN CRCW0603 series; value=1k; 1%
R4, R7: 10k; Resistor_SMD_R_0603_1608Metric; MPN CRCW0603 series; value=10k; 1%
U1: DRA818U; DRA818; MPN DRA818U
U2: TPS62160DGKR; Package_SO_VSSOP-8_3.0x3.0mm_P0.65mm; MPN TPS62160DGKR
U3: SN74LVC1G17DBVR; Package_TO_SOT_SMD_SOT-23-5; MPN SN74LVC1G17DBVR
U4: SN74LVC1G04DBVR; Package_TO_SOT_SMD_SOT-23-5; MPN SN74LVC1G04DBVR

Connections:
+3V3: C5.1, C6.1, J1.10, R7.2, U3.5, U4.5
+4V: C2.1, C3.1, C4.1, L1.2, R1.1, R4.2, U1.8 (VBAT), U2.6
+5V: C1.1, J1.1, U2.2, U2.3
AUDIO: C8.2, J1.8
AUDIO_RAW: C8.1, U1.3 (AF_OUT)
BUCK_FB: R1.2, R2.1, U2.5
BUCK_SW: L1.1, U2.7 (SW)
DRA_PTT_N: Q1.3, R4.1, U1.5 (PTT)
GND: C1.2, C2.2, C3.2, C4.2, C5.2, C6.2, C9.2, C10.2, C11.2, C12.2, J1.2, J1.9, J2.2, Q1.2, R2.2, R5.2, R6.2, U1.7, U1.9, U1.10, U2.1, U2.4, U3.3, U4.3
LP1: C10.1, L2.2, L3.1
LP2: C11.1, L3.2, L4.1
MIC: C7.1, J1.7
MIC_IN: C7.2, U1.18
PD: J1.6, R6.1, U1.6 (PD)
PTT_GATE: Q1.1, R5.1, U4.4 (Y)
PTT_N: J1.5, R7.1, U4.2
RF_FILTERED: C12.1, J2.1, L4.2
RF_RAW: C9.1, L2.1, U1.12
UART_IN: J1.3, R3.1
UART_IN_R: R3.2, U1.16 (RXD)
UART_OUT: J1.4, U3.4 (Y)
UART_OUT_RAW: U1.17 (TXD), U3.2

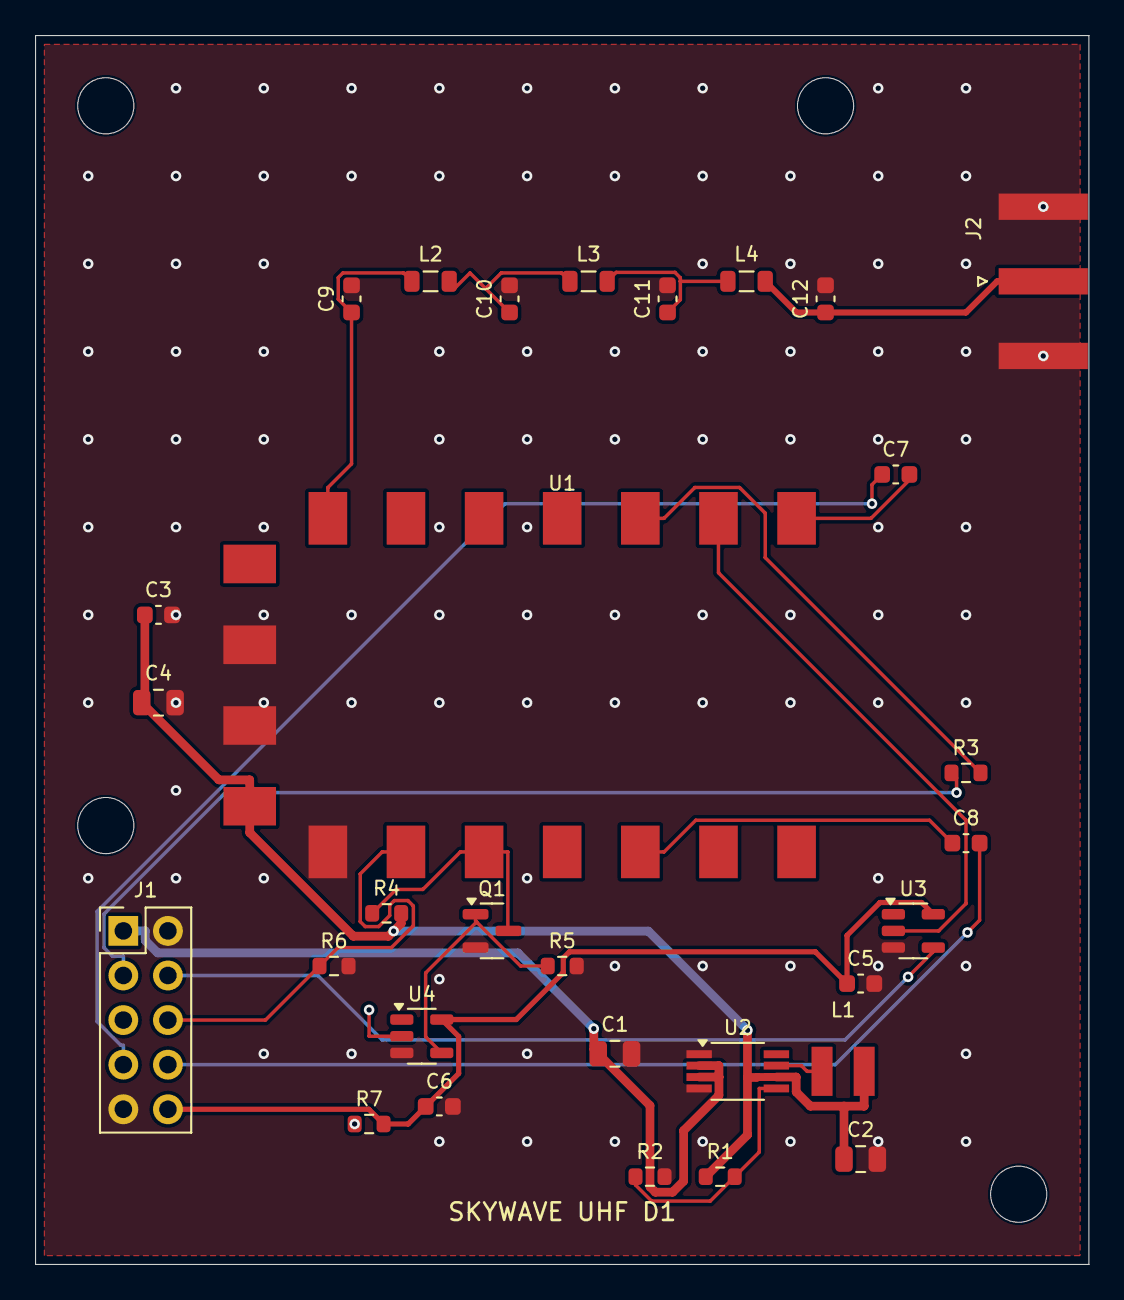
[picture p23: board uhf.kicad_pcb from above]

Board: 4 copper layers, 60.0 x 70.0 mm, 34 parts (0 on the bottom side), 22 nets.

Other parts of the board:
H1, H2, H3, H4: MountingHole_3.2mm_M3
