olegantonov/skywave-sdr/(commit log)

2026-10-12 feat(firmware): add ESP32 OLED PTT foundation and modular radio architecture (#1)
2026-10-12 feat: add D1 radio circuits PCBs tests and 3D enclosure
    A D0 tinha apenas a interface de firmware. Esta revisão acrescenta o circuito e os arquivos editáveis da primeira montagem de bancada: controle ESP32-S3/OLED/PTT/USB, HF I/Q, módulos VHF/UHF FM e quatro cartuchos de filtro HF. Inclui oito PCBs roteadas, BOM e fontes dos fabricantes, Gerber/Excellon, montagem STEP e gabinete paramétrico STEP/STL.
    Validação local: oito ERC/DRC sem erros, avisos ou conexões pendentes; 915 pads conferidos contra o circuito; seis filtros em ngspice e 1.800 casos de tolerância; sólidos válidos sem colisões entre placas/base/tampa; testes nativos com UBSan, quatro testes de contratos e builds das d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
